Sridarshan-b/Buck-Converter-soft-starting/Hardware/PCB.jpg

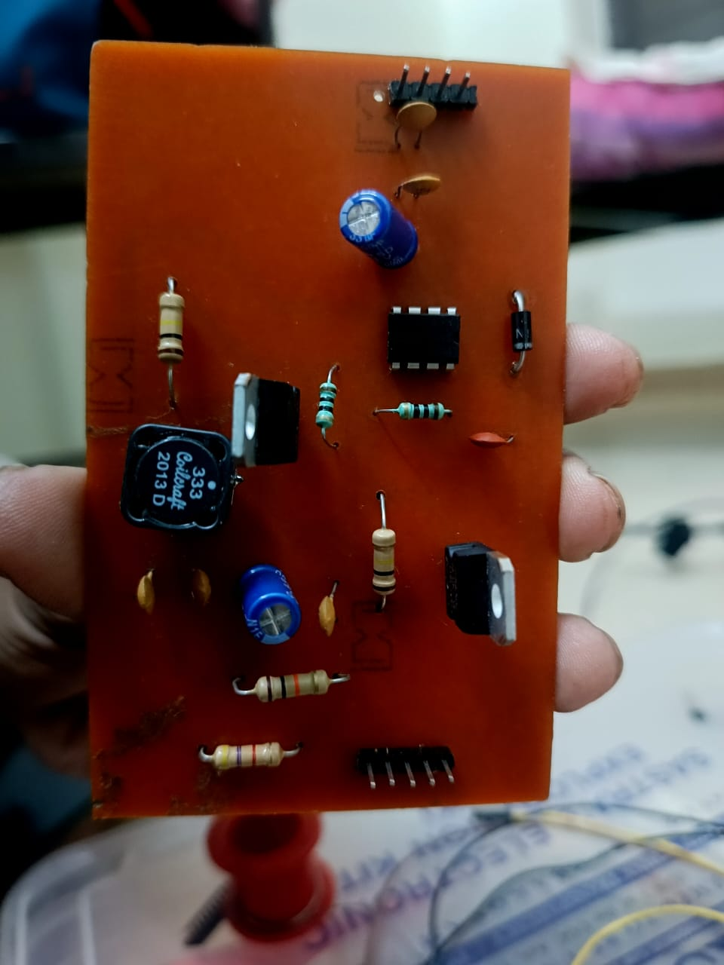
Hardware/PCB.jpg
