Sridarshan-b/Buck-Converter-soft-starting/Hardware/Hardware_test.jpg

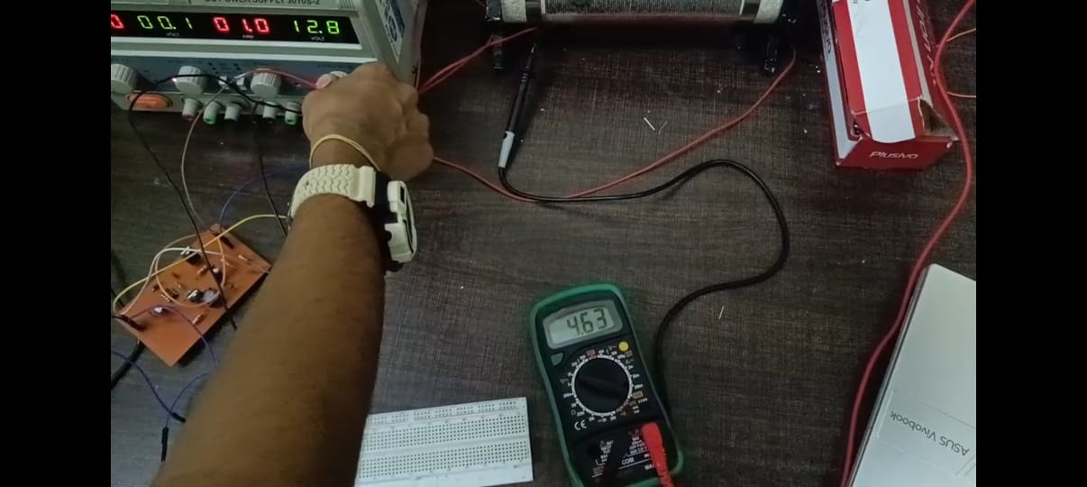
Hardware/Hardware_test.jpg
