Sridarshan-b/Buck-Converter-soft-starting/schematic/3D-view.jpg

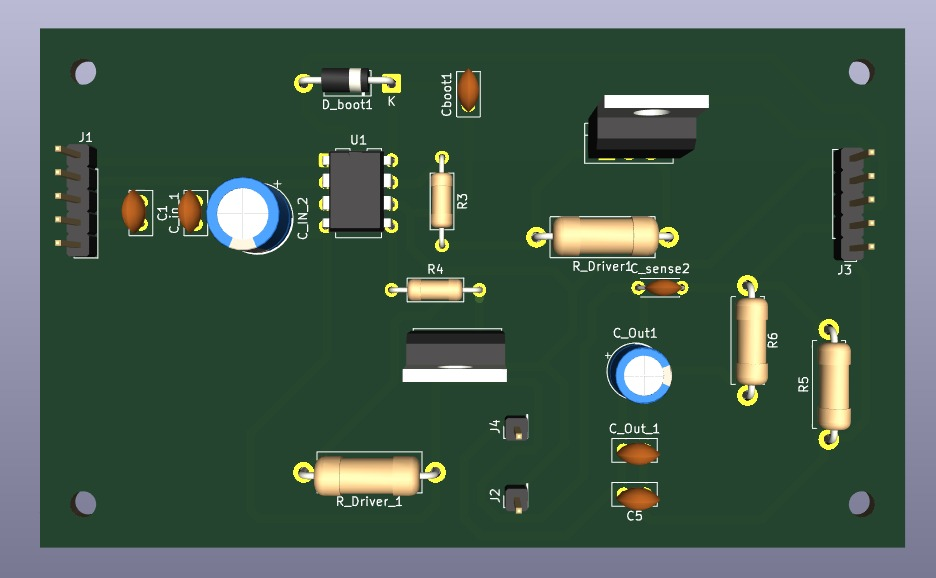
schematic/3D-view.jpg
