Sridarshan-b/Buck-Converter-soft-starting/schematic/edgecuts.jpg

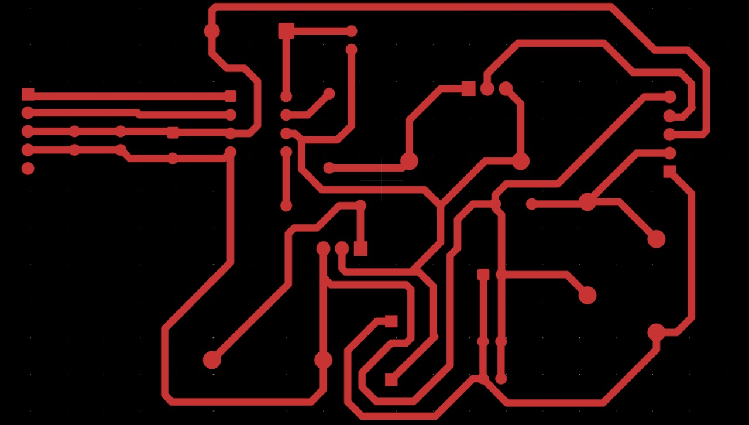
schematic/edgecuts.jpg
