Sridarshan-b/Buck-Converter-soft-starting/schematic/schematic.jpg

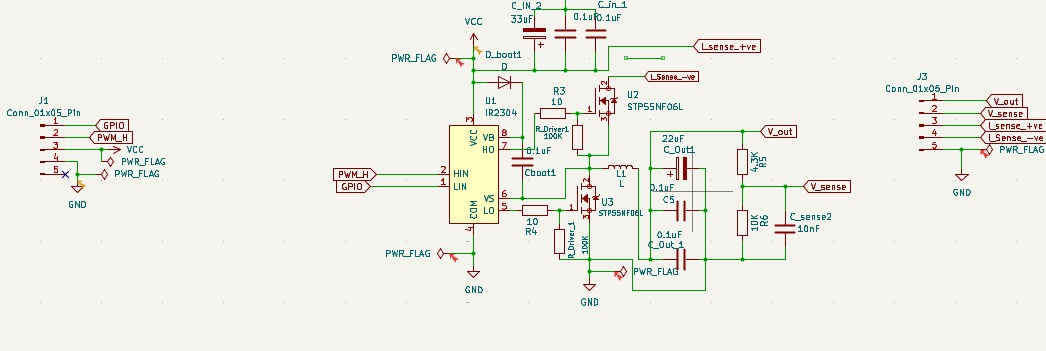
schematic/schematic.jpg
