Sridarshan-b/Buck-Converter-soft-starting/simulation/Simulation_results.png

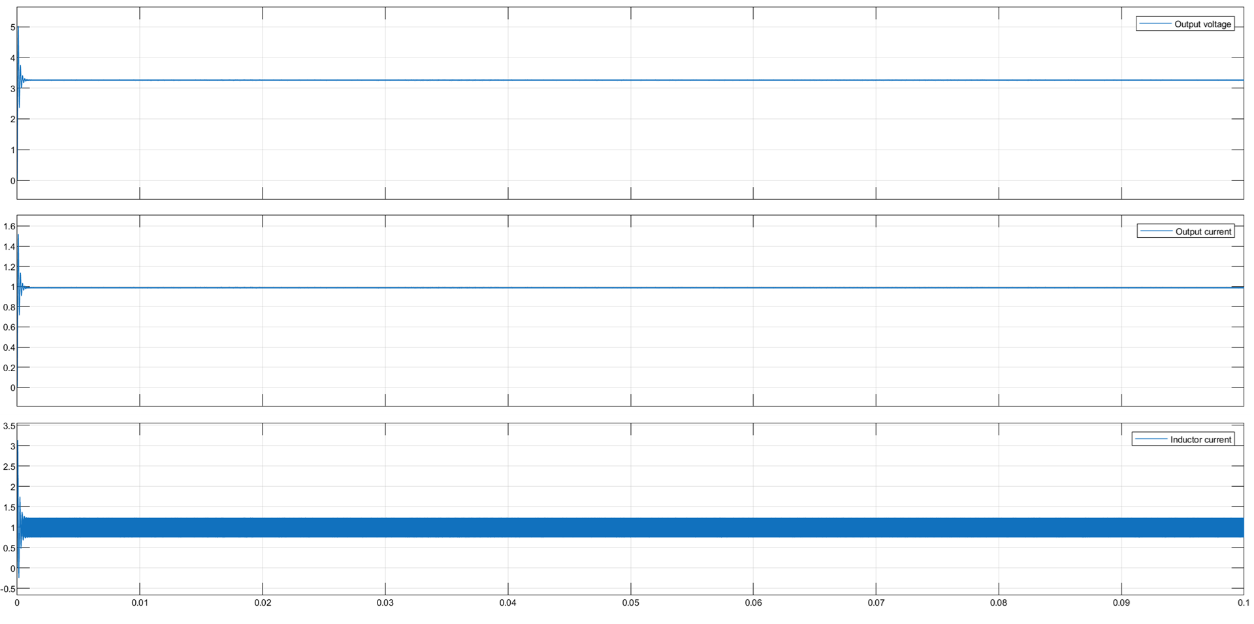
simulation/Simulation_results.png
