Sridarshan-b/Buck-Converter-soft-starting/simulation/circuit.pdf

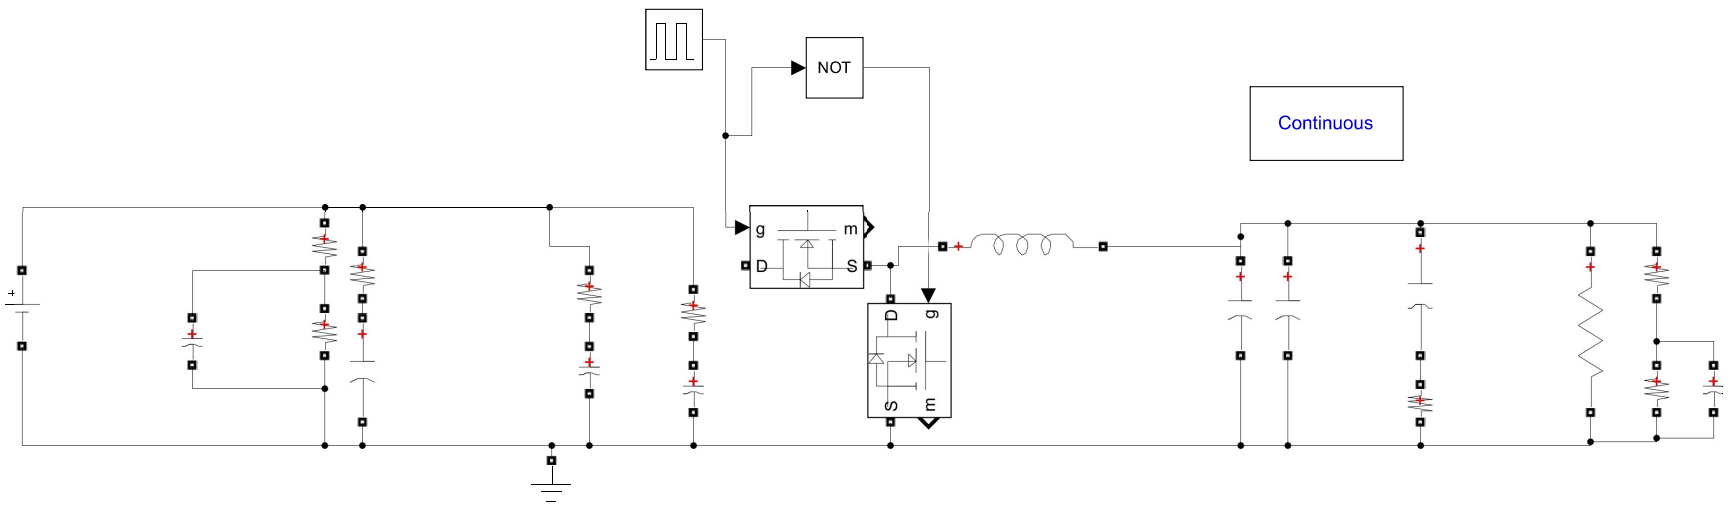
[picture p27: page 1]
